albertoboffi-PERSONAL/fra-clock/art/generated/art_dither_0.35mm.png

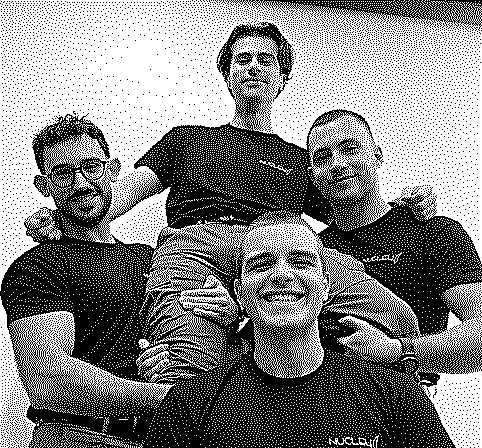
art/generated/art_dither_0.35mm.png
