albertoboffi-PERSONAL/fra-clock/art/generated/foto_neg.png

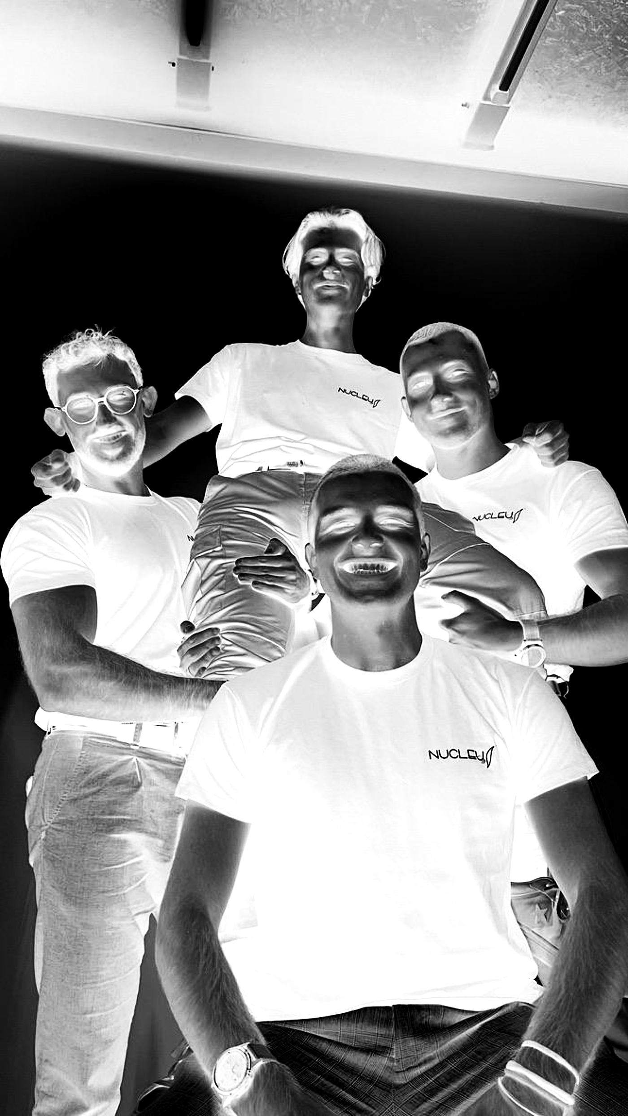
art/generated/foto_neg.png
