albertoboffi-PERSONAL/fra-clock/art/generated/preview_board.png

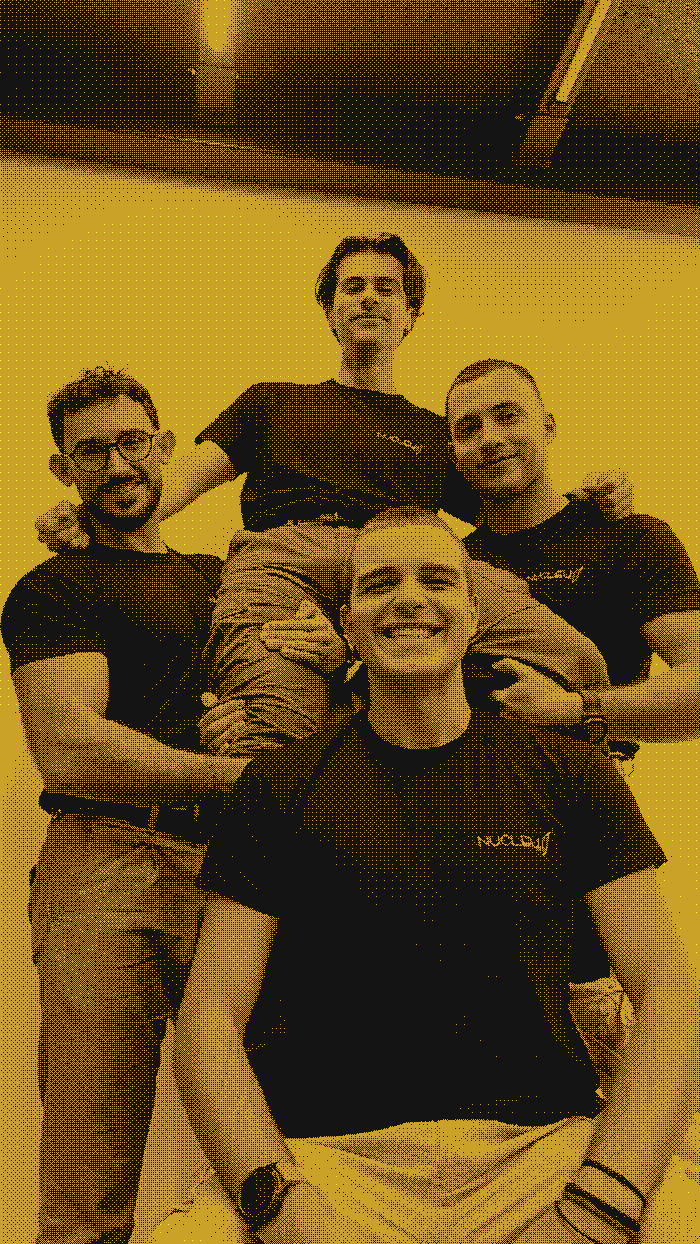
art/generated/preview_board.png
