albertoboffi-PERSONAL/fra-clock/art/source/foto.jpeg

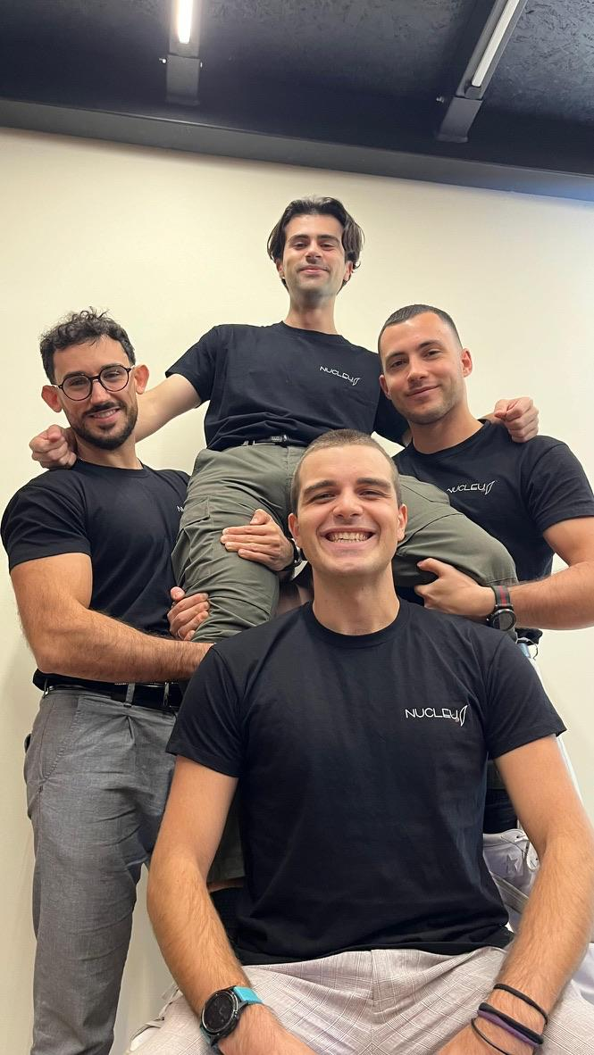
art/source/foto.jpeg
