albertoboffi-PERSONAL/fra-clock/docs/images/render_iso.png

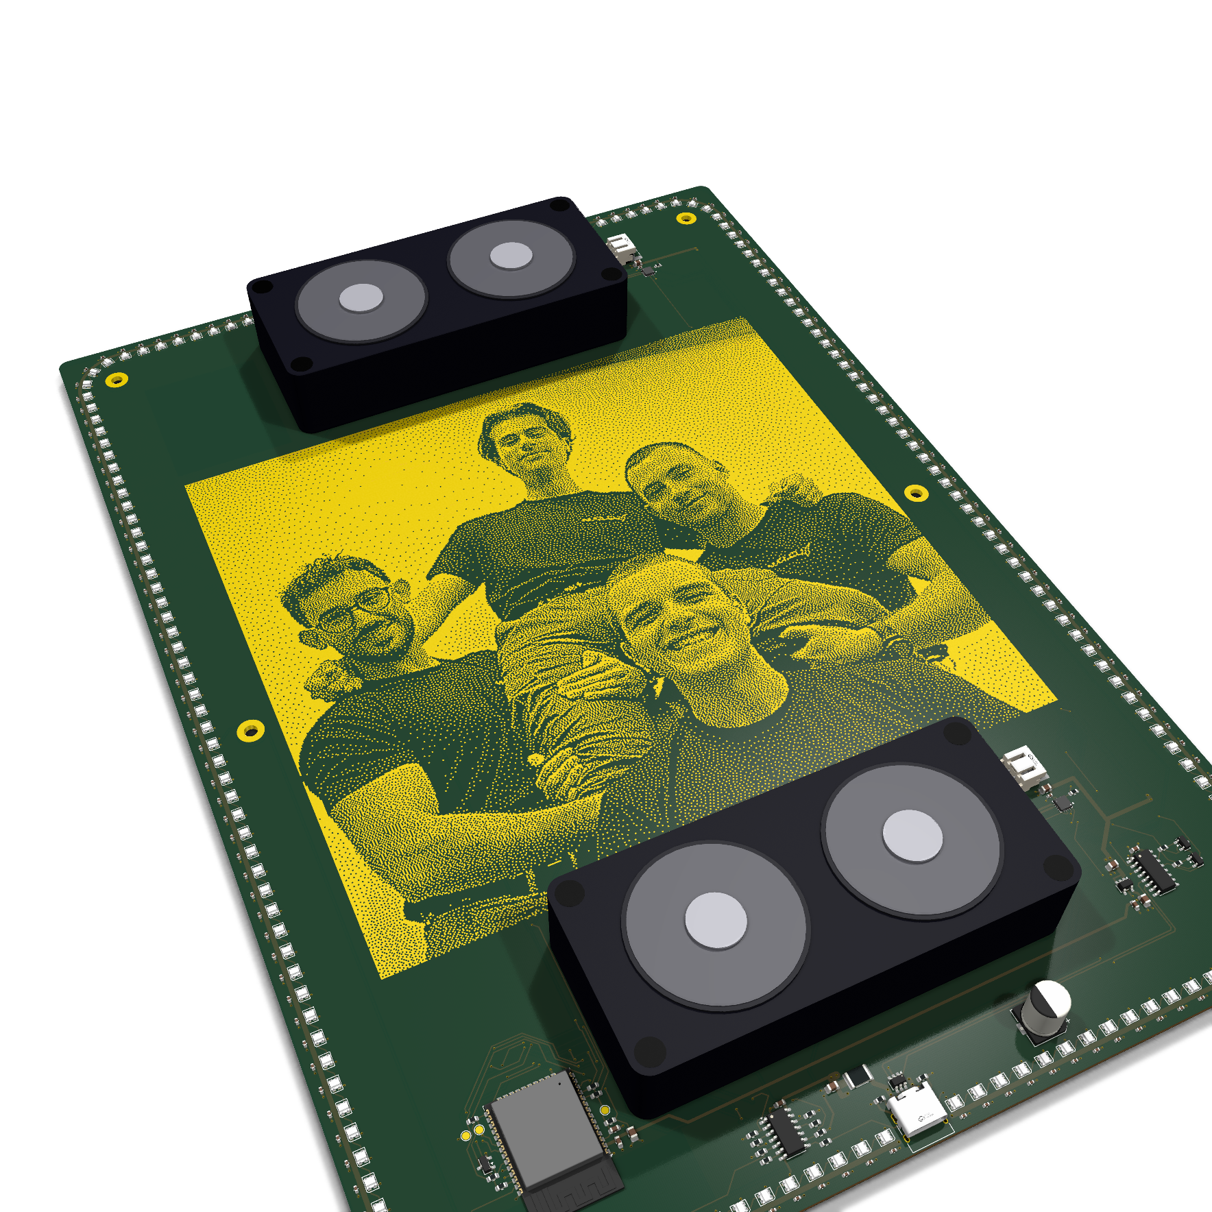
docs/images/render_iso.png
