albertoboffi-PERSONAL/fra-clock/production/preview/gerber_bottom.png

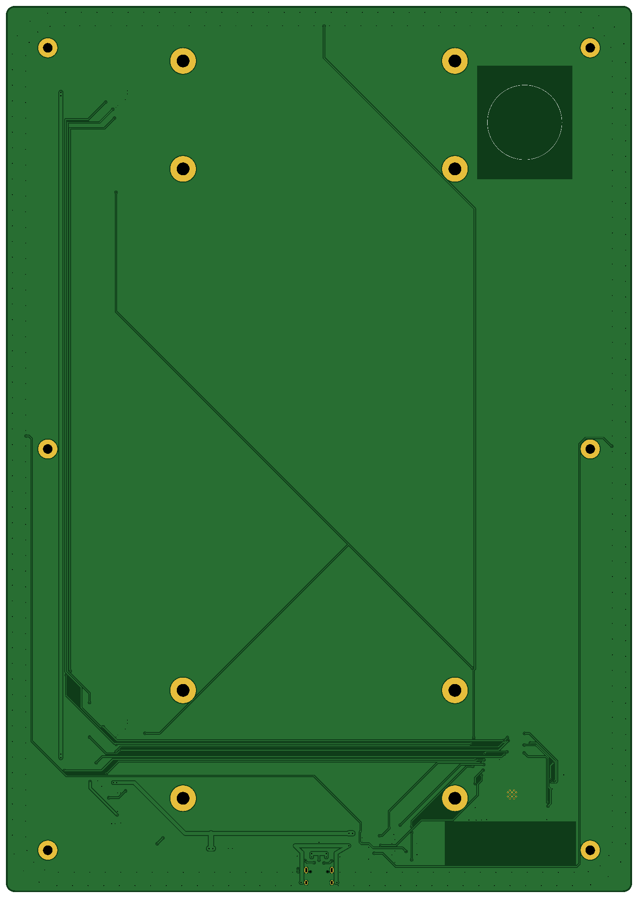
production/preview/gerber_bottom.png
