albertoboffi-PERSONAL/fra-clock/production/preview/gerber_top.png

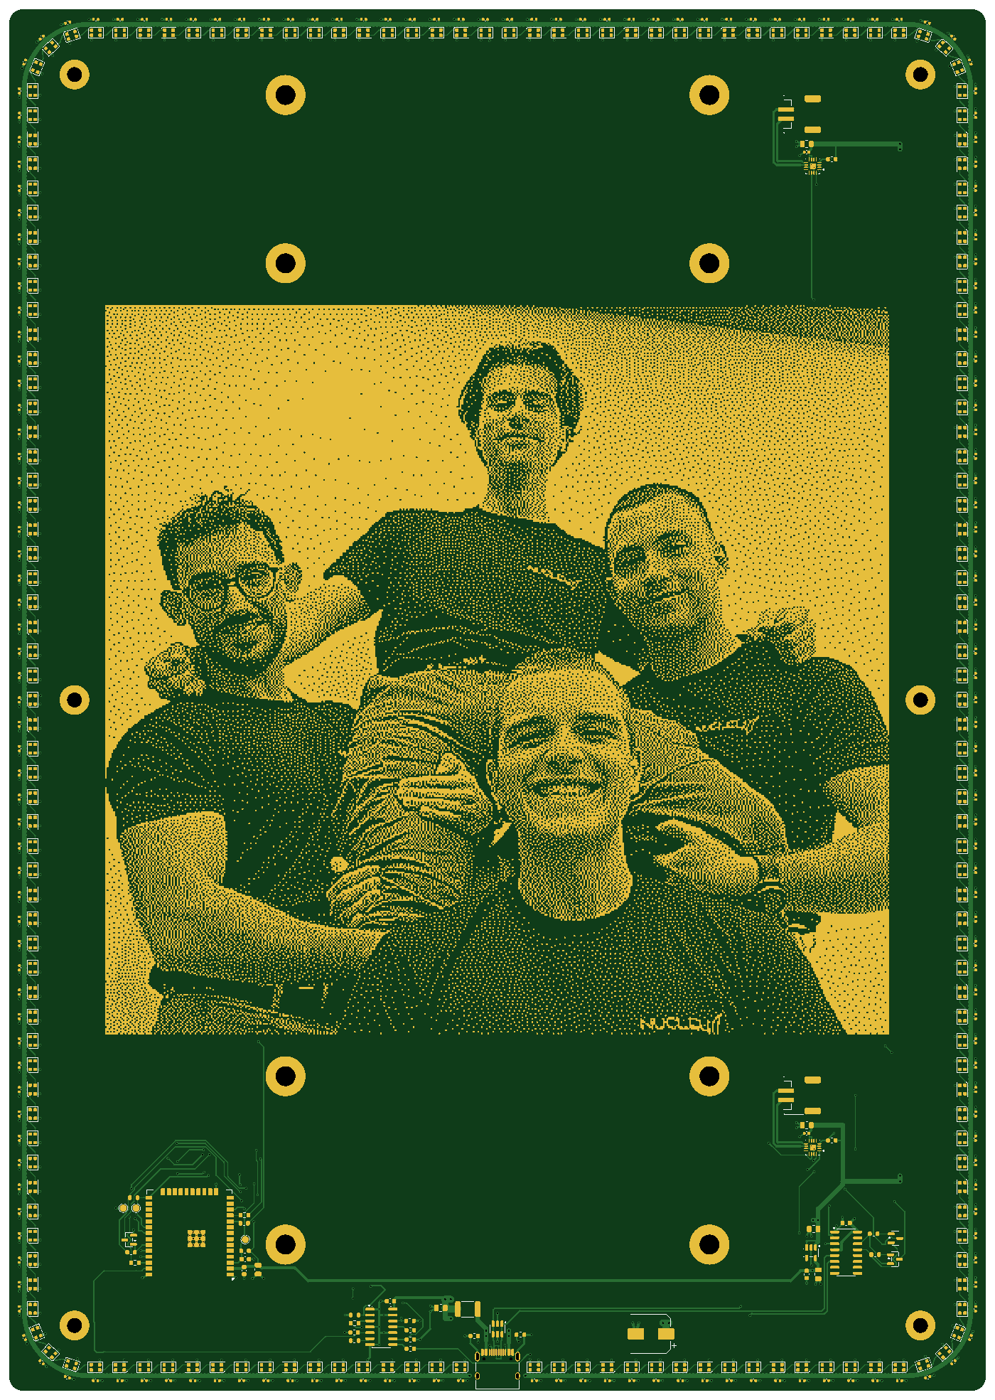
production/preview/gerber_top.png
