albertoboffi-PERSONAL/fra-clock/production/assembly/fra_clock_BOM_JLCPCB.csv

Comment | Designator | Footprint | LCSC Part # | Manufacturer Part | Quantity
100nF | C1,C5,C8,C70 | 0603 | C14663 | CC0603KRX7R9BB104 | 4
22uF | C2 | 0805 | C45783 | CL21A226MAQNNNE | 1
10uF | C3,C4,C6,C71,C72 | 0805 | C15850 | CL21A106KAYNNNE | 5
1uF | C7 | 0603 | C15849 | CL10A105KB8NNNC | 1
470uF | C69 | SMD D8xL10.2 | C82006 | RVT1C471M0810 (16V) | 1
100nF | C101,C102,C201,C202,C203,C204,C205,C206,C207,C208,C209,C210,C211,C212,C213,C214,C215,C216,C217,C218,C219,C220,C221,C222,C223,C224,C225,C226,C227,C228,C229,C230,C231,C232,C233,C234,C235,C236,C237,C238,C239,C240,C241,C242,C243,C244,C245,C301,C302,C303,C304,C305,C306,C307,C308,C309,C310,C311,C312,C313,C314,C315,C316,C317,C318,C319,C320,C321,C322,C323,C324,C325,C326,C327,C328,C329,C330,C331,C332,C333,C334,C335,C336,C337,C338,C339,C340,C341,C342,C343,C344,C345,C401,C402,C403,C404,C405,C406,C407,C408,C409,C410,C411,C412,C413,C414,C415,C416,C417,C418,C419,C420,C421,C422,C423,C424,C425,C426,C427,C428,C429,C430,C431,C432,C433,C434,C435,C436,C437,C438,C439,C440,C441,C442,C443,C444,C445,C501,C502,C503,C504,C505,C506,C507,C508,C509,C510,C511,C512,C513,C514,C515,C516,C517,C518,C519,C520,C521,C522,C523,C524,C525,C526,C527,C528,C529,C530,C531,C532,C533,C534,C535,C536,C537,C538,C539,C540,C541,C542,C543,C544,C545 | 0402 | C1525 | CL05B104KO5NNNC | 182
WS2812B-2020 | D201,D202,D203,D204,D205,D206,D207,D208,D209,D210,D211,D212,D213,D214,D215,D216,D217,D218,D219,D220,D221,D222,D223,D224,D225,D226,D227,D228,D229,D230,D231,D232,D233,D234,D235,D236,D237,D238,D239,D240,D241,D242,D243,D244,D245,D301,D302,D303,D304,D305,D306,D307,D308,D309,D310,D311,D312,D313,D314,D315,D316,D317,D318,D319,D320,D321,D322,D323,D324,D325,D326,D327,D328,D329,D330,D331,D332,D333,D334,D335,D336,D337,D338,D339,D340,D341,D342,D343,D344,D345,D401,D402,D403,D404,D405,D406,D407,D408,D409,D410,D411,D412,D413,D414,D415,D416,D417,D418,D419,D420,D421,D422,D423,D424,D425,D426,D427,D428,D429,D430,D431,D432,D433,D434,D435,D436,D437,D438,D439,D440,D441,D442,D443,D444,D445,D501,D502,D503,D504,D505,D506,D507,D508,D509,D510,D511,D512,D513,D514,D515,D516,D517,D518,D519,D520,D521,D522,D523,D524,D525,D526,D527,D528,D529,D530,D531,D532,D533,D534,D535,D536,D537,D538,D539,D540,D541,D542,D543,D544,D545 | 2020 | C965555 | WS2812B-2020 | 180
2A | F1 | 1812 | C20812 | SMD1812P200TF16 (PTC 2A hold) | 1
USB_C | J1 | USB-C SMD | C165948 | TYPE-C-31-M-12 | 1
S2B-PH-SM4-TB | J101,J102 | JST PH 2P SMD | C295747 | S2B-PH-SM4-TB(LF)(SN) | 2
MMBT3904 | Q1,Q2 | SOT-23 | C20526 | MMBT3904 | 2
2N7002 | Q3 | SOT-23 | C8545 | 2N7002 | 1
5.1k | R1,R2 | 0603 | C23186 | 0603WAF5101T5E | 2
10k | R3,R4,R5,R6,R7,R16,R17,R18 | 0603 | C25804 | 0603WAF1002T5E | 8
470 | R8,R13,R14,R15 | 0603 | C23179 | 0603WAF4700T5E | 4
100k | R9 | 0603 | C25803 | 0603WAF1003T5E | 1
33 | R10,R11,R12 | 0603 | C23140 | 0603WAF330JT5E | 3
1M | R101,R102 | 0603 | C22935 | 0603WAF1004T5E | 2
AP2112K-3.3 | U1 | SOT-23-5 | C51118 | AP2112K-3.3TRG1 | 1
USBLC6-2SC6 | U2 | SOT-23-6 | C7519 | USBLC6-2SC6 | 1
ESP32-WROOM-32E | U3 | Module | C701341 | ESP32-WROOM-32E-N4 | 1
CH340C | U5 | SOIC-16 | C84681 | CH340C | 1
74AHCT125 | U6 | SOIC-14 | C554502 | 74AHCT125D,118 | 1
MAX98357A | U101,U102 | TQFN-16 3x3 | C910544 | MAX98357AETE+T | 2
