albertoboffi-PERSONAL/fra-clock/hardware/fra_clock.kicad_pcb

## KiCad design hardware/fra_clock.kicad_pcb (2026-10-12)

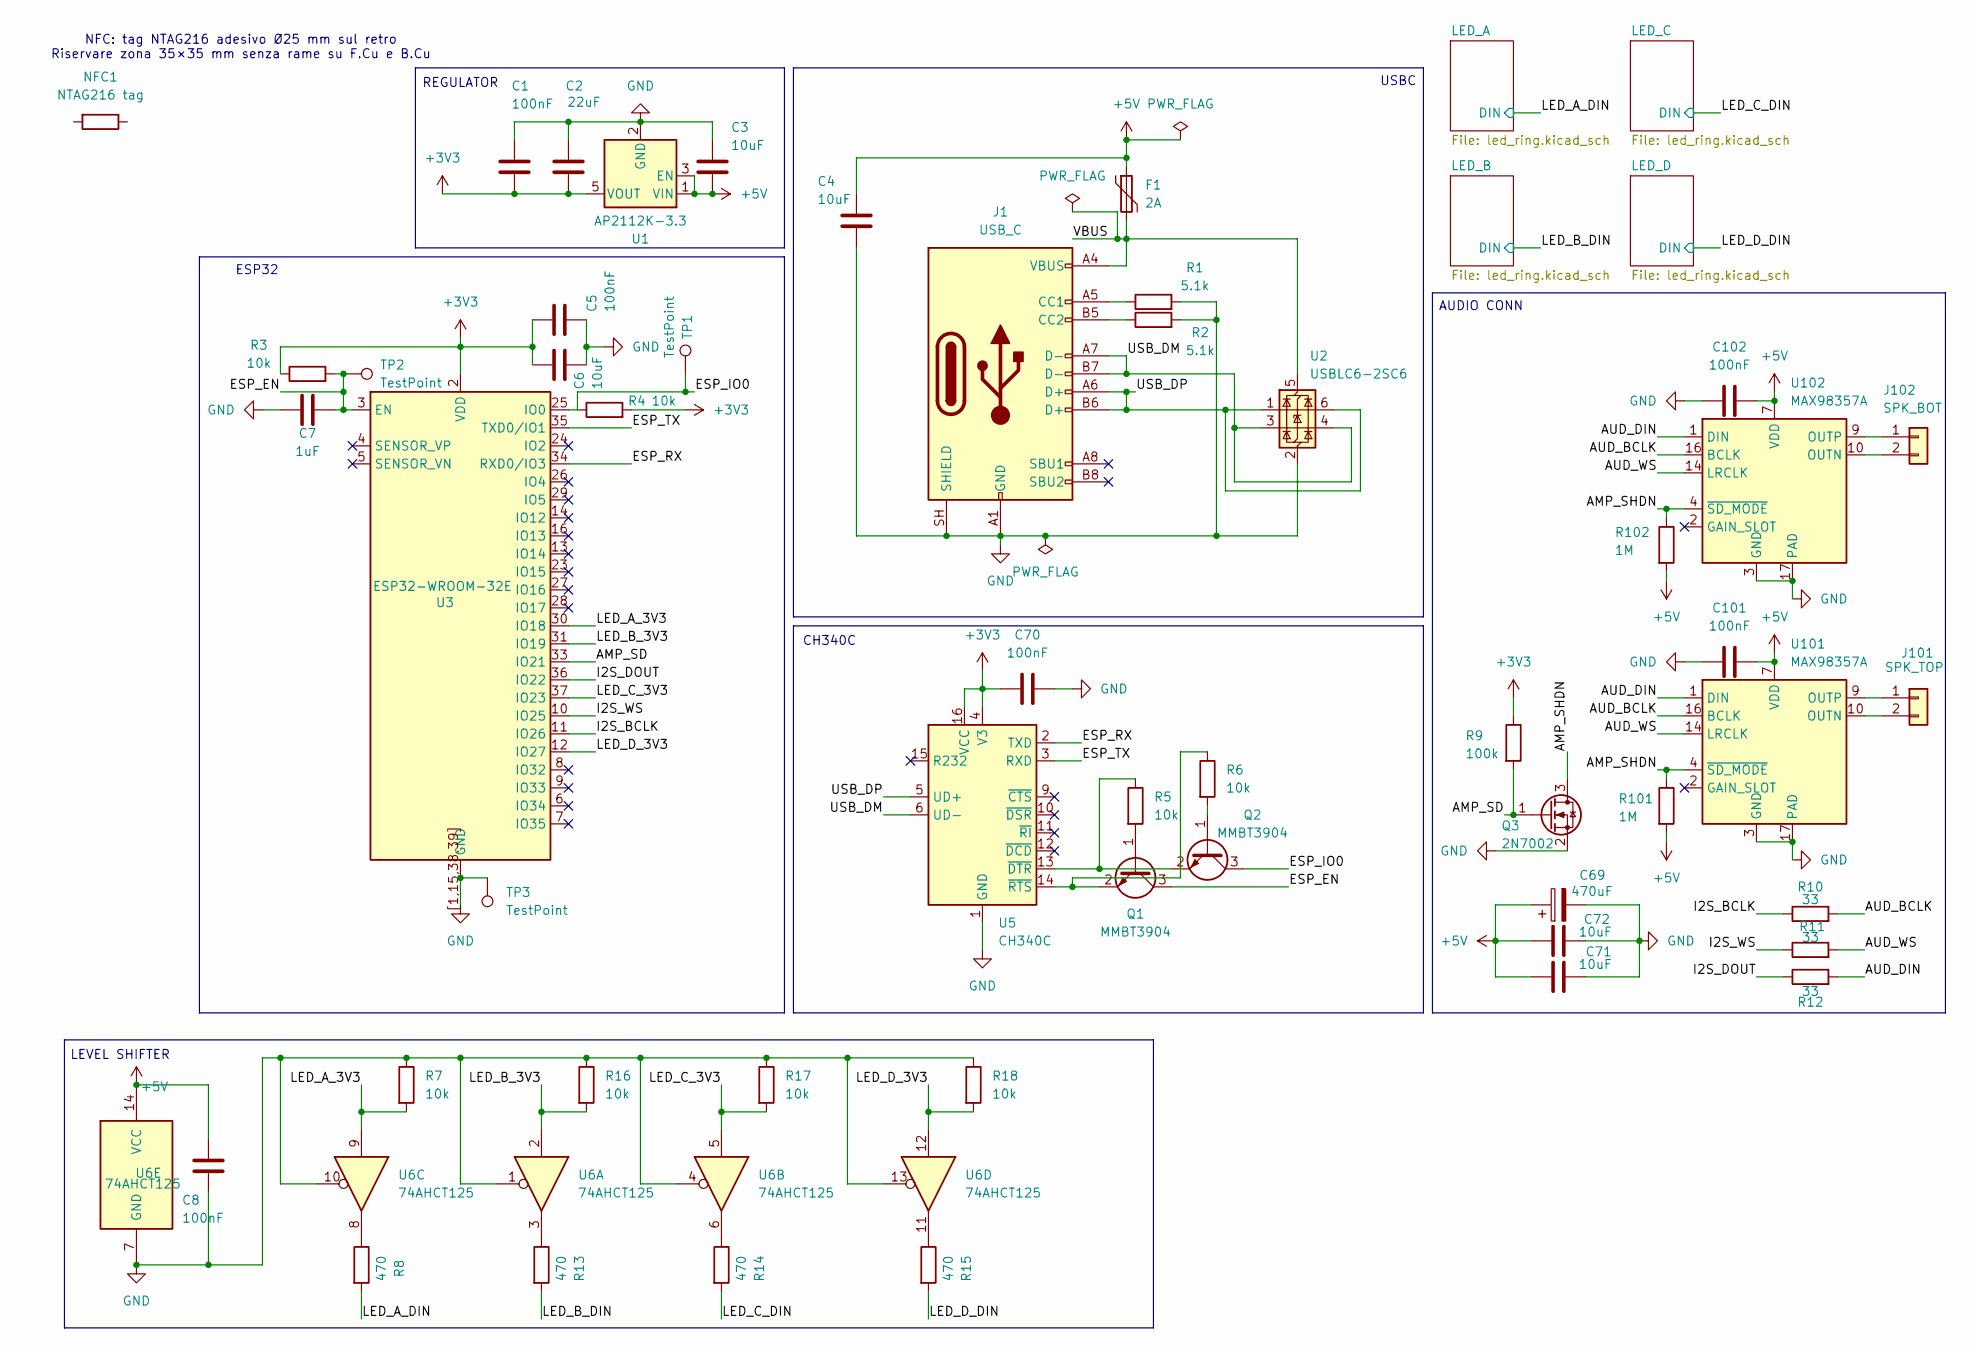
[picture p9: schematic fra_clock.kicad_sch]

Parts:
C1, C5, C8, C70: 100nF; C_0603_1608Metric
C2: 22uF; C_0805_2012Metric
C3, C4, C6, C71, C72: 10uF; C_0805_2012Metric
C7: 1uF; C_0603_1608Metric
C69: 470uF; CP_Elec_8x10
C101, C102: 100nF; C_0402_1005Metric
F1: 2A; Fuse_1812_4532Metric
J1: USB_C; USB_C_Receptacle_HRO_TYPE-C-31-M-12
J101: SPK_TOP; JST_PH_S2B-PH-SM4-TB_1x02-1MP_P2.00mm_Horizontal
J102: SPK_BOT; JST_PH_S2B-PH-SM4-TB_1x02-1MP_P2.00mm_Horizontal
NFC1: NTAG216 tag
Q1, Q2: MMBT3904; SOT-23
Q3: 2N7002; SOT-23
R1, R2: 5.1k; R_0603_1608Metric
R3, R4, R5, R6, R7, R16, R17, R18: 10k; R_0603_1608Metric
R8, R13, R14, R15: 470; R_0603_1608Metric
R9: 100k; R_0603_1608Metric
R10, R11, R12: 33; R_0603_1608Metric
R101, R102: 1M; R_0603_1608Metric
TP1, TP2, TP3: TestPoint; TestPoint_Pad_D1.5mm
U1: AP2112K-3.3; SOT-23-5
U2: USBLC6-2SC6; SOT-23-6
U3: ESP32-WROOM-32E
U5: CH340C; SOIC-16_3.9x9.9mm_P1.27mm
U6: 74AHCT125; SOIC-14_3.9x8.7mm_P1.27mm
U101, U102: MAX98357A; TQFN-16-1EP_3x3mm_P0.5mm_EP1.23x1.23mm

Connections:
+3V3: C1.2, C2.2, C5.1, C6.1, C70.1, R3.1, R4.2, R9.1, U1.5 (VOUT), U3.2 (VDD), U5.4 (V3), U5.16 (VCC)
+5V: C3.2, C4.1, C8.1, C69.1, C71.1, C72.1, C101.1, C102.1, F1.1, R101.2, R102.2, U1.1 (VIN), U1.3 (EN), U6.14 (VCC), U101.7 (VDD), U101.8 (VDD), U102.7 (VDD), U102.8 (VDD); also elsewhere on the board
/AMP_SD: Q3.1 (G), R9.2, U3.33 (IO21)
/AMP_SHDN: Q3.3 (D), R101.1, R102.1, U101.4 (~SD_MODE), U102.4 (~SD_MODE)
/AUD_BCLK: R10.2, U101.16 (BCLK), U102.16 (BCLK)
/AUD_DIN: R12.2, U101.1 (DIN), U102.1 (DIN)
/AUD_WS: R11.2, U101.14 (LRCLK), U102.14 (LRCLK)
/ESP_EN: C7.1, Q1.3 (C), R3.2, TP2.1 (1_1), U3.3 (EN)
/ESP_IO0: Q2.3 (C), R4.1, TP1.1 (1_1), U3.25 (IO0)
/ESP_RX: U3.34 (RXD0/IO3), U5.2 (TXD)
/ESP_TX: U3.35 (TXD0/IO1), U5.3 (RXD)
/I2S_BCLK: R10.1, U3.11 (IO26)
/I2S_DOUT: R12.1, U3.36 (IO22)
/I2S_WS: R11.1, U3.10 (IO25)
/LED_A_3V3: R7.2, U3.30 (IO18), U6.9
/LED_A_DIN: R8.2; also elsewhere on the board
/LED_B_3V3: R16.2, U3.31 (IO19), U6.2
/LED_B_DIN: R13.2; also elsewhere on the board
/LED_C_3V3: R17.2, U3.37 (IO23), U6.5
/LED_C_DIN: R14.2; also elsewhere on the board
/LED_D_3V3: R18.2, U3.12 (IO27), U6.12
/LED_D_DIN: R15.2; also elsewhere on the board
/USB_DM: J1.A7 (D-), J1.B7 (D-), U2.3 (I/O2), U2.4 (I/O2), U5.6 (UD-)
/USB_DP: J1.A6 (D+), J1.B6 (D+), U2.1 (I/O1), U2.6 (I/O1), U5.5 (UD+)
/VBUS: F1.2, J1.A4 (VBUS), J1.A9 (VBUS), J1.B4 (VBUS), J1.B9 (VBUS), U2.5 (VBUS)
GND: C1.1, C2.1, C3.1, C4.2, C5.2, C6.2, C7.2, C8.2, C69.2, C70.2, C71.2, C72.2, C101.2, C102.2, J1.A1 (GND), J1.A12 (GND), J1.B1 (GND), J1.B12 (GND), J1.SH (SHIELD), Q3.2 (S), R1.2, R2.2, R7.1, R16.1, R17.1, R18.1, TP3.1 (1_1), U1.2 (GND), U2.2 (GND), U3.1 (GND), U3.15 (GND), U3.38 (GND), U3.39 (GND), U3.[1,15,38,39] (GND), U5.1 (GND), U6.1, U6.4, U6.7 (GND), U6.10, U6.13, U101.3 (GND), U101.11 (GND), U101.15 (GND), U101.17 (PAD), U102.3 (GND), U102.11 (GND), U102.15 (GND), U102.17 (PAD); also elsewhere on the board
unnamed: J1.A5 (CC1), R1.1
unnamed: J1.B5 (CC2), R2.1
unnamed: J101.1, U101.9 (OUTP)
unnamed: J101.2, U101.10 (OUTN)
unnamed: J102.1, U102.9 (OUTP)
unnamed: J102.2, U102.10 (OUTN)
unnamed: Q1.1 (B), R5.2
unnamed: Q1.2 (E), R6.1, U5.14 (~RTS)
unnamed: Q2.1 (B), R6.2
unnamed: Q2.2 (E), R5.1, U5.13 (~DTR)
unnamed: R8.1, U6.8
unnamed: R13.1, U6.3
unnamed: R14.1, U6.6
unnamed: R15.1, U6.11

Notes on the sheet:
CH340C
USBC
LEVEL SHIFTER
NFC: tag NTAG216 adesivo Ø25 mm sul retro Riservare zona 35×35 mm senza rame su F.Cu e B.Cu
AUDIO CONN
REGULATOR
ESP32

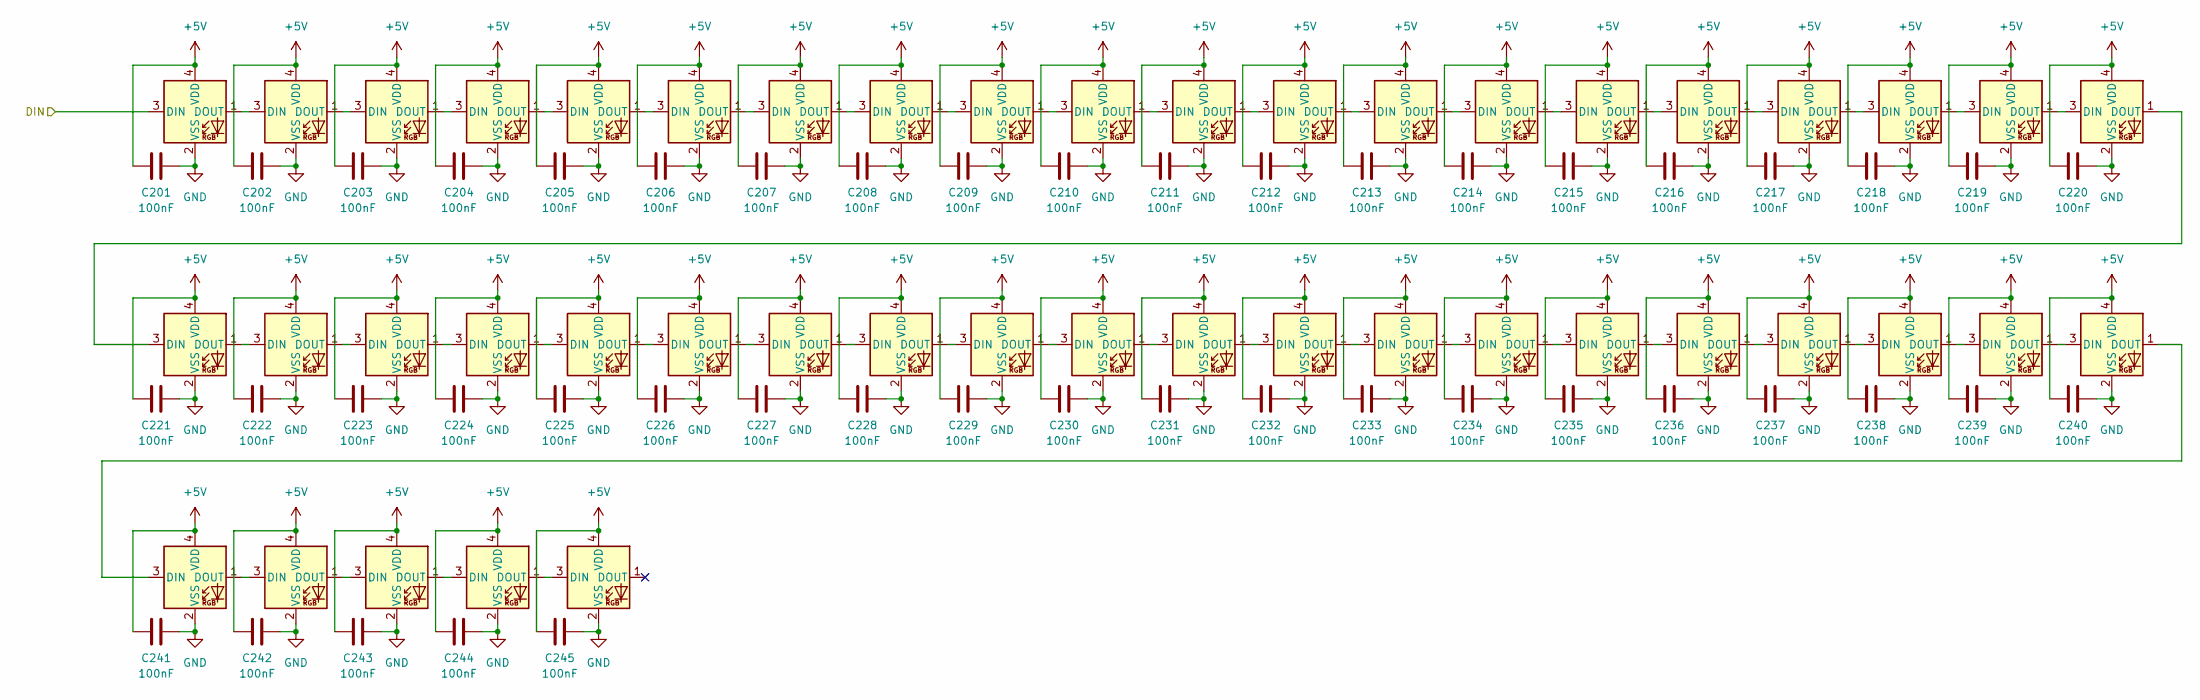
[picture p10: schematic led_ring.kicad_sch]

Parts:
C201, C202, C203, C204, C205, C206, C207, C208, C209, C210, C211, C212, C213, C214, C215, C216, C217, C218, C219, C220, C221, C222, C223, C224, C225, C226, C227, C228, C229, C230, C231, C232, C233, C234, C235, C236, C237, C238, C239, C240, C241, C242, C243, C244, C245: 100nF; C_0402_1005Metric
D201, D202, D203, D204, D205, D206, D207, D208, D209, D210, D211, D212, D213, D214, D215, D216, D217, D218, D219, D220, D221, D222, D223, D224, D225, D226, D227, D228, D229, D230, D231, D232, D233, D234, D235, D236, D237, D238, D239, D240, D241, D242, D243, D244, D245: WS2812B-2020; LED_WS2812B-2020_PLCC4_2.0x2.0mm

Connections:
+5V: C201.2, C202.2, C203.2, C204.2, C205.2, C206.2, C207.2, C208.2, C209.2, C210.2, C211.2, C212.2, C213.2, C214.2, C215.2, C216.2, C217.2, C218.2, C219.2, C220.2, C221.2, C222.2, C223.2, C224.2, C225.2, C226.2, C227.2, C228.2, C229.2, C230.2, C231.2, C232.2, C233.2, C234.2, C235.2, C236.2, C237.2, C238.2, C239.2, C240.2, C241.2, C242.2, C243.2, C244.2, C245.2, D201.4 (VDD), D202.4 (VDD), D203.4 (VDD), D204.4 (VDD), D205.4 (VDD), D206.4 (VDD), D207.4 (VDD), D208.4 (VDD), D209.4 (VDD), D210.4 (VDD), D211.4 (VDD), D212.4 (VDD), D213.4 (VDD), D214.4 (VDD), D215.4 (VDD), D216.4 (VDD), D217.4 (VDD), D218.4 (VDD), D219.4 (VDD), D220.4 (VDD), D221.4 (VDD), D222.4 (VDD), D223.4 (VDD), D224.4 (VDD), D225.4 (VDD), D226.4 (VDD), D227.4 (VDD), D228.4 (VDD), D229.4 (VDD), D230.4 (VDD), D231.4 (VDD), D232.4 (VDD), D233.4 (VDD), D234.4 (VDD), D235.4 (VDD), D236.4 (VDD), D237.4 (VDD), D238.4 (VDD), D239.4 (VDD), D240.4 (VDD), D241.4 (VDD), D242.4 (VDD), D243.4 (VDD), D244.4 (VDD), D245.4 (VDD); also elsewhere on the board
/LED_A_DIN: D201.3 (DIN); also elsewhere on the board
GND: C201.1, C202.1, C203.1, C204.1, C205.1, C206.1, C207.1, C208.1, C209.1, C210.1, C211.1, C212.1, C213.1, C214.1, C215.1, C216.1, C217.1, C218.1, C219.1, C220.1, C221.1, C222.1, C223.1, C224.1, C225.1, C226.1, C227.1, C228.1, C229.1, C230.1, C231.1, C232.1, C233.1, C234.1, C235.1, C236.1, C237.1, C238.1, C239.1, C240.1, C241.1, C242.1, C243.1, C244.1, C245.1, D201.2 (VSS), D202.2 (VSS), D203.2 (VSS), D204.2 (VSS), D205.2 (VSS), D206.2 (VSS), D207.2 (VSS), D208.2 (VSS), D209.2 (VSS), D210.2 (VSS), D211.2 (VSS), D212.2 (VSS), D213.2 (VSS), D214.2 (VSS), D215.2 (VSS), D216.2 (VSS), D217.2 (VSS), D218.2 (VSS), D219.2 (VSS), D220.2 (VSS), D221.2 (VSS), D222.2 (VSS), D223.2 (VSS), D224.2 (VSS), D225.2 (VSS), D226.2 (VSS), D227.2 (VSS), D228.2 (VSS), D229.2 (VSS), D230.2 (VSS), D231.2 (VSS), D232.2 (VSS), D233.2 (VSS), D234.2 (VSS), D235.2 (VSS), D236.2 (VSS), D237.2 (VSS), D238.2 (VSS), D239.2 (VSS), D240.2 (VSS), D241.2 (VSS), D242.2 (VSS), D243.2 (VSS), D244.2 (VSS), D245.2 (VSS); also elsewhere on the board
unnamed: D201.1 (DOUT), D202.3 (DIN)
unnamed: D202.1 (DOUT), D203.3 (DIN)
unnamed: D203.1 (DOUT), D204.3 (DIN)
unnamed: D204.1 (DOUT), D205.3 (DIN)
unnamed: D205.1 (DOUT), D206.3 (DIN)
unnamed: D206.1 (DOUT), D207.3 (DIN)
unnamed: D207.1 (DOUT), D208.3 (DIN)
unnamed: D208.1 (DOUT), D209.3 (DIN)
unnamed: D209.1 (DOUT), D210.3 (DIN)
unnamed: D210.1 (DOUT), D211.3 (DIN)
unnamed: D211.1 (DOUT), D212.3 (DIN)
unnamed: D212.1 (DOUT), D213.3 (DIN)
unnamed: D213.1 (DOUT), D214.3 (DIN)
unnamed: D214.1 (DOUT), D215.3 (DIN)
unnamed: D215.1 (DOUT), D216.3 (DIN)
unnamed: D216.1 (DOUT), D217.3 (DIN)
unnamed: D217.1 (DOUT), D218.3 (DIN)
unnamed: D218.1 (DOUT), D219.3 (DIN)
unnamed: D219.1 (DOUT), D220.3 (DIN)
unnamed: D220.1 (DOUT), D221.3 (DIN)
unnamed: D221.1 (DOUT), D222.3 (DIN)
unnamed: D222.1 (DOUT), D223.3 (DIN)
unnamed: D223.1 (DOUT), D224.3 (DIN)
unnamed: D224.1 (DOUT), D225.3 (DIN)
unnamed: D225.1 (DOUT), D226.3 (DIN)
unnamed: D226.1 (DOUT), D227.3 (DIN)
unnamed: D227.1 (DOUT), D228.3 (DIN)
unnamed: D228.1 (DOUT), D229.3 (DIN)
unnamed: D229.1 (DOUT), D230.3 (DIN)
unnamed: D230.1 (DOUT), D231.3 (DIN)
unnamed: D231.1 (DOUT), D232.3 (DIN)
unnamed: D232.1 (DOUT), D233.3 (DIN)
unnamed: D233.1 (DOUT), D234.3 (DIN)
unnamed: D234.1 (DOUT), D235.3 (DIN)
unnamed: D235.1 (DOUT), D236.3 (DIN)
unnamed: D236.1 (DOUT), D237.3 (DIN)
unnamed: D237.1 (DOUT), D238.3 (DIN)
unnamed: D238.1 (DOUT), D239.3 (DIN)
unnamed: D239.1 (DOUT), D240.3 (DIN)
unnamed: D240.1 (DOUT), D241.3 (DIN)
unnamed: D241.1 (DOUT), D242.3 (DIN)
unnamed: D242.1 (DOUT), D243.3 (DIN)
unnamed: D243.1 (DOUT), D244.3 (DIN)
unnamed: D244.1 (DOUT), D245.3 (DIN)

Parts of its further copies:
C301, C302, C303, C304, C305, C306, C307, C308, C309, C310, C311, C312, C313, C314, C315, C316, C317, C318, C319, C320, C321, C322, C323, C324, C325, C326, C327, C328, C329, C330, C331, C332, C333, C334, C335, C336, C337, C338, C339, C340, C341, C342, C343, C344, C345, C401, C402, C403, C404, C405, C406, C407, C408, C409, C410, C411, C412, C413, C414, C415, C416, C417, C418, C419, C420, C421, C422, C423, C424, C425, C426, C427, C428, C429, C430, C431, C432, C433, C434, C435, C436, C437, C438, C439, C440, C441, C442, C443, C444, C445, C501, C502, C503, C504, C505, C506, C507, C508, C509, C510, C511, C512, C513, C514, C515, C516, C517, C518, C519, C520, C521, C522, C523, C524, C525, C526, C527, C528, C529, C530, C531, C532, C533, C534, C535, C536, C537, C538, C539, C540, C541, C542, C543, C544, C545: 100nF; C_0402_1005Metric
D301, D302, D303, D304, D305, D306, D307, D308, D309, D310, D311, D312, D313, D314, D315, D316, D317, D318, D319, D320, D321, D322, D323, D324, D325, D326, D327, D328, D329, D330, D331, D332, D333, D334, D335, D336, D337, D338, D339, D340, D341, D342, D343, D344, D345, D401, D402, D403, D404, D405, D406, D407, D408, D409, D410, D411, D412, D413, D414, D415, D416, D417, D418, D419, D420, D421, D422, D423, D424, D425, D426, D427, D428, D429, D430, D431, D432, D433, D434, D435, D436, D437, D438, D439, D440, D441, D442, D443, D444, D445, D501, D502, D503, D504, D505, D506, D507, D508, D509, D510, D511, D512, D513, D514, D515, D516, D517, D518, D519, D520, D521, D522, D523, D524, D525, D526, D527, D528, D529, D530, D531, D532, D533, D534, D535, D536, D537, D538, D539, D540, D541, D542, D543, D544, D545: WS2812B-2020; LED_WS2812B-2020_PLCC4_2.0x2.0mm

Connections of its further copies:
+5V: C301.2, C302.2, C303.2, C304.2, C305.2, C306.2, C307.2, C308.2, C309.2, C310.2, C311.2, C312.2, C313.2, C314.2, C315.2, C316.2, C317.2, C318.2, C319.2, C320.2, C321.2, C322.2, C323.2, C324.2, C325.2, C326.2, C327.2, C328.2, C329.2, C330.2, C331.2, C332.2, C333.2, C334.2, C335.2, C336.2, C337.2, C338.2, C339.2, C340.2, C341.2, C342.2, C343.2, C344.2, C345.2, C401.2, C402.2, C403.2, C404.2, C405.2, C406.2, C407.2, C408.2, C409.2, C410.2, C411.2, C412.2, C413.2, C414.2, C415.2, C416.2, C417.2, C418.2, C419.2, C420.2, C421.2, C422.2, C423.2, C424.2, C425.2, C426.2, C427.2, C428.2, C429.2, C430.2, C431.2, C432.2, C433.2, C434.2, C435.2, C436.2, C437.2, C438.2, C439.2, C440.2, C441.2, C442.2, C443.2, C444.2, C445.2, C501.2, C502.2, C503.2, C504.2, C505.2, C506.2, C507.2, C508.2, C509.2, C510.2, C511.2, C512.2, C513.2, C514.2, C515.2, C516.2, C517.2, C518.2, C519.2, C520.2, C521.2, C522.2, C523.2, C524.2, C525.2, C526.2, C527.2, C528.2, C529.2, C530.2, C531.2, C532.2, C533.2, C534.2, C535.2, C536.2, C537.2, C538.2, C539.2, C540.2, C541.2, C542.2, C543.2, C544.2, C545.2, D301.4 (VDD), D302.4 (VDD), D303.4 (VDD), D304.4 (VDD), D305.4 (VDD), D306.4 (VDD), D307.4 (VDD), D308.4 (VDD), D309.4 (VDD), D310.4 (VDD), D311.4 (VDD), D312.4 (VDD), D313.4 (VDD), D314.4 (VDD), D315.4 (VDD), D316.4 (VDD), D317.4 (VDD), D318.4 (VDD), D319.4 (VDD), D320.4 (VDD), D321.4 (VDD), D322.4 (VDD), D323.4 (VDD), D324.4 (VDD), D325.4 (VDD), D326.4 (VDD), D327.4 (VDD), D328.4 (VDD), D329.4 (VDD), D330.4 (VDD), D331.4 (VDD), D332.4 (VDD), D333.4 (VDD), D334.4 (VDD), D335.4 (VDD), D336.4 (VDD), D337.4 (VDD), D338.4 (VDD), D339.4 (VDD), D340.4 (VDD), D341.4 (VDD), D342.4 (VDD), D343.4 (VDD), D344.4 (VDD), D345.4 (VDD), D401.4 (VDD), D402.4 (VDD), D403.4 (VDD), D404.4 (VDD), D405.4 (VDD), D406.4 (VDD), D407.4 (VDD), D408.4 (VDD), D409.4 (VDD), D410.4 (VDD), D411.4 (VDD), D412.4 (VDD), D413.4 (VDD), D414.4 (VDD), D415.4 (VDD), D416.4 (VDD), D417.4 (VDD), D418.4 (VDD), D419.4 (VDD), D420.4 (VDD), D421.4 (VDD), D422.4 (VDD), D423.4 (VDD), D424.4 (VDD), D425.4 (VDD), D426.4 (VDD), D427.4 (VDD), D428.4 (VDD), D429.4 (VDD), D430.4 (VDD), D431.4 (VDD), D432.4 (VDD), D433.4 (VDD), D434.4 (VDD), D435.4 (VDD), D436.4 (VDD), D437.4 (VDD), D438.4 (VDD), D439.4 (VDD), D440.4 (VDD), D441.4 (VDD), D442.4 (VDD), D443.4 (VDD), D444.4 (VDD), D445.4 (VDD), D501.4 (VDD), D502.4 (VDD), D503.4 (VDD), D504.4 (VDD), D505.4 (VDD), D506.4 (VDD), D507.4 (VDD), D508.4 (VDD), D509.4 (VDD), D510.4 (VDD), D511.4 (VDD), D512.4 (VDD), D513.4 (VDD), D514.4 (VDD), D515.4 (VDD), D516.4 (VDD), D517.4 (VDD), D518.4 (VDD), D519.4 (VDD), D520.4 (VDD), D521.4 (VDD), D522.4 (VDD), D523.4 (VDD), D524.4 (VDD), D525.4 (VDD), D526.4 (VDD), D527.4 (VDD), D528.4 (VDD), D529.4 (VDD), D530.4 (VDD), D531.4 (VDD), D532.4 (VDD), D533.4 (VDD), D534.4 (VDD), D535.4 (VDD), D536.4 (VDD), D537.4 (VDD), D538.4 (VDD), D539.4 (VDD), D540.4 (VDD), D541.4 (VDD), D542.4 (VDD), D543.4 (VDD), D544.4 (VDD), D545.4 (VDD); also elsewhere on the board
/LED_B_DIN: D301.3 (DIN); also elsewhere on the board
/LED_C_DIN: D401.3 (DIN); also elsewhere on the board
/LED_D_DIN: D501.3 (DIN); also elsewhere on the board
GND: C301.1, C302.1, C303.1, C304.1, C305.1, C306.1, C307.1, C308.1, C309.1, C310.1, C311.1, C312.1, C313.1, C314.1, C315.1, C316.1, C317.1, C318.1, C319.1, C320.1, C321.1, C322.1, C323.1, C324.1, C325.1, C326.1, C327.1, C328.1, C329.1, C330.1, C331.1, C332.1, C333.1, C334.1, C335.1, C336.1, C337.1, C338.1, C339.1, C340.1, C341.1, C342.1, C343.1, C344.1, C345.1, C401.1, C402.1, C403.1, C404.1, C405.1, C406.1, C407.1, C408.1, C409.1, C410.1, C411.1, C412.1, C413.1, C414.1, C415.1, C416.1, C417.1, C418.1, C419.1, C420.1, C421.1, C422.1, C423.1, C424.1, C425.1, C426.1, C427.1, C428.1, C429.1, C430.1, C431.1, C432.1, C433.1, C434.1, C435.1, C436.1, C437.1, C438.1, C439.1, C440.1, C441.1, C442.1, C443.1, C444.1, C445.1, C501.1, C502.1, C503.1, C504.1, C505.1, C506.1, C507.1, C508.1, C509.1, C510.1, C511.1, C512.1, C513.1, C514.1, C515.1, C516.1, C517.1, C518.1, C519.1, C520.1, C521.1, C522.1, C523.1, C524.1, C525.1, C526.1, C527.1, C528.1, C529.1, C530.1, C531.1, C532.1, C533.1, C534.1, C535.1, C536.1, C537.1, C538.1, C539.1, C540.1, C541.1, C542.1, C543.1, C544.1, C545.1, D301.2 (VSS), D302.2 (VSS), D303.2 (VSS), D304.2 (VSS), D305.2 (VSS), D306.2 (VSS), D307.2 (VSS), D308.2 (VSS), D309.2 (VSS), D310.2 (VSS), D311.2 (VSS), D312.2 (VSS), D313.2 (VSS), D314.2 (VSS), D315.2 (VSS), D316.2 (VSS), D317.2 (VSS), D318.2 (VSS), D319.2 (VSS), D320.2 (VSS), D321.2 (VSS), D322.2 (VSS), D323.2 (VSS), D324.2 (VSS), D325.2 (VSS), D326.2 (VSS), D327.2 (VSS), D328.2 (VSS), D329.2 (VSS), D330.2 (VSS), D331.2 (VSS), D332.2 (VSS), D333.2 (VSS), D334.2 (VSS), D335.2 (VSS), D336.2 (VSS), D337.2 (VSS), D338.2 (VSS), D339.2 (VSS), D340.2 (VSS), D341.2 (VSS), D342.2 (VSS), D343.2 (VSS), D344.2 (VSS), D345.2 (VSS), D401.2 (VSS), D402.2 (VSS), D403.2 (VSS), D404.2 (VSS), D405.2 (VSS), D406.2 (VSS), D407.2 (VSS), D408.2 (VSS), D409.2 (VSS), D410.2 (VSS), D411.2 (VSS), D412.2 (VSS), D413.2 (VSS), D414.2 (VSS), D415.2 (VSS), D416.2 (VSS), D417.2 (VSS), D418.2 (VSS), D419.2 (VSS), D420.2 (VSS), D421.2 (VSS), D422.2 (VSS), D423.2 (VSS), D424.2 (VSS), D425.2 (VSS), D426.2 (VSS), D427.2 (VSS), D428.2 (VSS), D429.2 (VSS), D430.2 (VSS), D431.2 (VSS), D432.2 (VSS), D433.2 (VSS), D434.2 (VSS), D435.2 (VSS), D436.2 (VSS), D437.2 (VSS), D438.2 (VSS), D439.2 (VSS), D440.2 (VSS), D441.2 (VSS), D442.2 (VSS), D443.2 (VSS), D444.2 (VSS), D445.2 (VSS), D501.2 (VSS), D502.2 (VSS), D503.2 (VSS), D504.2 (VSS), D505.2 (VSS), D506.2 (VSS), D507.2 (VSS), D508.2 (VSS), D509.2 (VSS), D510.2 (VSS), D511.2 (VSS), D512.2 (VSS), D513.2 (VSS), D514.2 (VSS), D515.2 (VSS), D516.2 (VSS), D517.2 (VSS), D518.2 (VSS), D519.2 (VSS), D520.2 (VSS), D521.2 (VSS), D522.2 (VSS), D523.2 (VSS), D524.2 (VSS), D525.2 (VSS), D526.2 (VSS), D527.2 (VSS), D528.2 (VSS), D529.2 (VSS), D530.2 (VSS), D531.2 (VSS), D532.2 (VSS), D533.2 (VSS), D534.2 (VSS), D535.2 (VSS), D536.2 (VSS), D537.2 (VSS), D538.2 (VSS), D539.2 (VSS), D540.2 (VSS), D541.2 (VSS), D542.2 (VSS), D543.2 (VSS), D544.2 (VSS), D545.2 (VSS); also elsewhere on the board
unnamed: D301.1 (DOUT), D302.3 (DIN)
unnamed: D302.1 (DOUT), D303.3 (DIN)
unnamed: D303.1 (DOUT), D304.3 (DIN)
unnamed: D304.1 (DOUT), D305.3 (DIN)
unnamed: D305.1 (DOUT), D306.3 (DIN)
unnamed: D306.1 (DOUT), D307.3 (DIN)
unnamed: D307.1 (DOUT), D308.3 (DIN)
unnamed: D308.1 (DOUT), D309.3 (DIN)
unnamed: D309.1 (DOUT), D310.3 (DIN)
unnamed: D310.1 (DOUT), D311.3 (DIN)
unnamed: D311.1 (DOUT), D312.3 (DIN)
unnamed: D312.1 (DOUT), D313.3 (DIN)
unnamed: D313.1 (DOUT), D314.3 (DIN)
unnamed: D314.1 (DOUT), D315.3 (DIN)
unnamed: D315.1 (DOUT), D316.3 (DIN)
unnamed: D316.1 (DOUT), D317.3 (DIN)
unnamed: D317.1 (DOUT), D318.3 (DIN)
unnamed: D318.1 (DOUT), D319.3 (DIN)
unnamed: D319.1 (DOUT), D320.3 (DIN)
unnamed: D320.1 (DOUT), D321.3 (DIN)
unnamed: D321.1 (DOUT), D322.3 (DIN)
unnamed: D322.1 (DOUT), D323.3 (DIN)
unnamed: D323.1 (DOUT), D324.3 (DIN)
unnamed: D324.1 (DOUT), D325.3 (DIN)
unnamed: D325.1 (DOUT), D326.3 (DIN)
unnamed: D326.1 (DOUT), D327.3 (DIN)
unnamed: D327.1 (DOUT), D328.3 (DIN)
unnamed: D328.1 (DOUT), D329.3 (DIN)
unnamed: D329.1 (DOUT), D330.3 (DIN)
unnamed: D330.1 (DOUT), D331.3 (DIN)
unnamed: D331.1 (DOUT), D332.3 (DIN)
unnamed: D332.1 (DOUT), D333.3 (DIN)
unnamed: D333.1 (DOUT), D334.3 (DIN)
unnamed: D334.1 (DOUT), D335.3 (DIN)
unnamed: D335.1 (DOUT), D336.3 (DIN)
unnamed: D336.1 (DOUT), D337.3 (DIN)
unnamed: D337.1 (DOUT), D338.3 (DIN)
unnamed: D338.1 (DOUT), D339.3 (DIN)
unnamed: D339.1 (DOUT), D340.3 (DIN)
unnamed: D340.1 (DOUT), D341.3 (DIN)
unnamed: D341.1 (DOUT), D342.3 (DIN)
unnamed: D342.1 (DOUT), D343.3 (DIN)
unnamed: D343.1 (DOUT), D344.3 (DIN)
unnamed: D344.1 (DOUT), D345.3 (DIN)
unnamed: D401.1 (DOUT), D402.3 (DIN)
unnamed: D402.1 (DOUT), D403.3 (DIN)
unnamed: D403.1 (DOUT), D404.3 (DIN)
unnamed: D404.1 (DOUT), D405.3 (DIN)
unnamed: D405.1 (DOUT), D406.3 (DIN)
unnamed: D406.1 (DOUT), D407.3 (DIN)
unnamed: D407.1 (DOUT), D408.3 (DIN)
unnamed: D408.1 (DOUT), D409.3 (DIN)
unnamed: D409.1 (DOUT), D410.3 (DIN)
unnamed: D410.1 (DOUT), D411.3 (DIN)
unnamed: D411.1 (DOUT), D412.3 (DIN)
unnamed: D412.1 (DOUT), D413.3 (DIN)
unnamed: D413.1 (DOUT), D414.3 (DIN)
unnamed: D414.1 (DOUT), D415.3 (DIN)
unnamed: D415.1 (DOUT), D416.3 (DIN)
unnamed: D416.1 (DOUT), D417.3 (DIN)
unnamed: D417.1 (DOUT), D418.3 (DIN)
unnamed: D418.1 (DOUT), D419.3 (DIN)
unnamed: D419.1 (DOUT), D420.3 (DIN)
unnamed: D420.1 (DOUT), D421.3 (DIN)
unnamed: D421.1 (DOUT), D422.3 (DIN)
unnamed: D422.1 (DOUT), D423.3 (DIN)
unnamed: D423.1 (DOUT), D424.3 (DIN)
unnamed: D424.1 (DOUT), D425.3 (DIN)
unnamed: D425.1 (DOUT), D426.3 (DIN)
unnamed: D426.1 (DOUT), D427.3 (DIN)
unnamed: D427.1 (DOUT), D428.3 (DIN)
unnamed: D428.1 (DOUT), D429.3 (DIN)
unnamed: D429.1 (DOUT), D430.3 (DIN)
unnamed: D430.1 (DOUT), D431.3 (DIN)
unnamed: D431.1 (DOUT), D432.3 (DIN)
unnamed: D432.1 (DOUT), D433.3 (DIN)
unnamed: D433.1 (DOUT), D434.3 (DIN)
unnamed: D434.1 (DOUT), D435.3 (DIN)
unnamed: D435.1 (DOUT), D436.3 (DIN)
unnamed: D436.1 (DOUT), D437.3 (DIN)
unnamed: D437.1 (DOUT), D438.3 (DIN)
unnamed: D438.1 (DOUT), D439.3 (DIN)
unnamed: D439.1 (DOUT), D440.3 (DIN)
unnamed: D440.1 (DOUT), D441.3 (DIN)
unnamed: D441.1 (DOUT), D442.3 (DIN)
unnamed: D442.1 (DOUT), D443.3 (DIN)
unnamed: D443.1 (DOUT), D444.3 (DIN)
unnamed: D444.1 (DOUT), D445.3 (DIN)
unnamed: D501.1 (DOUT), D502.3 (DIN)
unnamed: D502.1 (DOUT), D503.3 (DIN)
unnamed: D503.1 (DOUT), D504.3 (DIN)
unnamed: D504.1 (DOUT), D505.3 (DIN)
unnamed: D505.1 (DOUT), D506.3 (DIN)
unnamed: D506.1 (DOUT), D507.3 (DIN)
unnamed: D507.1 (DOUT), D508.3 (DIN)
unnamed: D508.1 (DOUT), D509.3 (DIN)
unnamed: D509.1 (DOUT), D510.3 (DIN)
unnamed: D510.1 (DOUT), D511.3 (DIN)
unnamed: D511.1 (DOUT), D512.3 (DIN)
unnamed: D512.1 (DOUT), D513.3 (DIN)
unnamed: D513.1 (DOUT), D514.3 (DIN)
unnamed: D514.1 (DOUT), D515.3 (DIN)
unnamed: D515.1 (DOUT), D516.3 (DIN)
unnamed: D516.1 (DOUT), D517.3 (DIN)
unnamed: D517.1 (DOUT), D518.3 (DIN)
unnamed: D518.1 (DOUT), D519.3 (DIN)
unnamed: D519.1 (DOUT), D520.3 (DIN)
unnamed: D520.1 (DOUT), D521.3 (DIN)
unnamed: D521.1 (DOUT), D522.3 (DIN)
unnamed: D522.1 (DOUT), D523.3 (DIN)
unnamed: D523.1 (DOUT), D524.3 (DIN)
unnamed: D524.1 (DOUT), D525.3 (DIN)
unnamed: D525.1 (DOUT), D526.3 (DIN)
unnamed: D526.1 (DOUT), D527.3 (DIN)
unnamed: D527.1 (DOUT), D528.3 (DIN)
unnamed: D528.1 (DOUT), D529.3 (DIN)
unnamed: D529.1 (DOUT), D530.3 (DIN)
unnamed: D530.1 (DOUT), D531.3 (DIN)
unnamed: D531.1 (DOUT), D532.3 (DIN)
unnamed: D532.1 (DOUT), D533.3 (DIN)
unnamed: D533.1 (DOUT), D534.3 (DIN)
unnamed: D534.1 (DOUT), D535.3 (DIN)
unnamed: D535.1 (DOUT), D536.3 (DIN)
unnamed: D536.1 (DOUT), D537.3 (DIN)
unnamed: D537.1 (DOUT), D538.3 (DIN)
unnamed: D538.1 (DOUT), D539.3 (DIN)
unnamed: D539.1 (DOUT), D540.3 (DIN)
unnamed: D540.1 (DOUT), D541.3 (DIN)
unnamed: D541.1 (DOUT), D542.3 (DIN)
unnamed: D542.1 (DOUT), D543.3 (DIN)
unnamed: D543.1 (DOUT), D544.3 (DIN)
unnamed: D544.1 (DOUT), D545.3 (DIN)

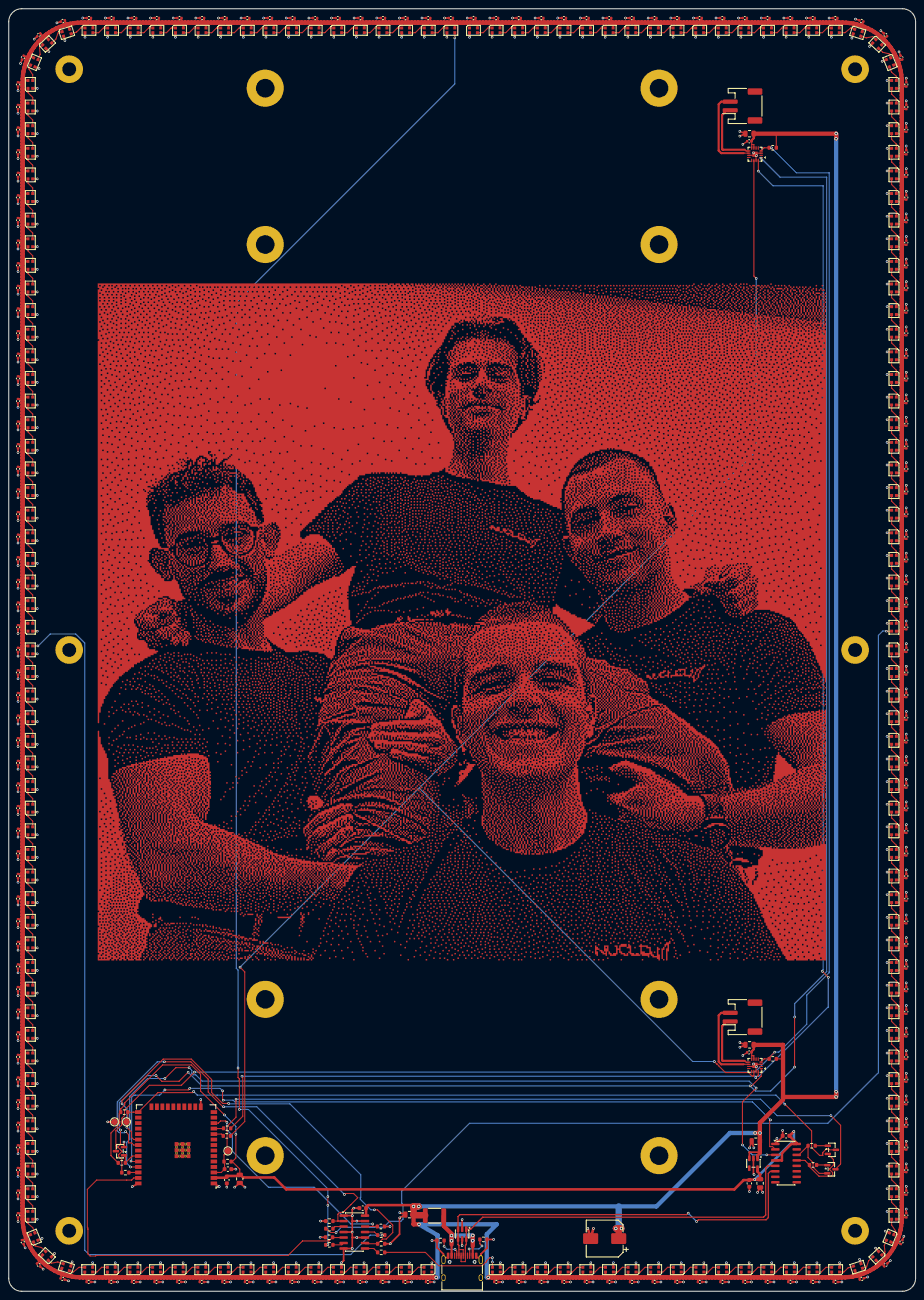
[picture p11: board fra_clock.kicad_pcb from above]

Board: 2 copper layers, 210.0 x 297.0 mm, 428 parts (0 on the bottom side), 216 nets.

Other parts of the board:
ART1: ART_FOTO
H1, H2, H7, H8, H13, H14: MountingHole_3.2mm_M3_Pad
H3, H4, H5, H6, H9, H10, H11, H12: MountingHole_4.3mm_M4_Pad
LS1, LS2: CE08483; Speaker_Makerverse_CE08483_100x45
