albertoboffi-PERSONAL/fra-clock/(commit log)

2026-10-11 pre-routing
    Claude-Session: https://claude.ai/code/session_01UYk7fLNsQphaXPRGVQJ5XY
    [fra_clock.dsn, fra_clock.kicad_pcb, fra_clock.kicad_sch, led_ring.kicad_sch]
2026-10-11 Phase A: critical routing (CRITICAL_AUTO) - power, USB, audio outputs, GND vias
    DRC A: 0 errors besides unconnected Phase-B nets; warnings: 14 pre-existing lib_footprint_mismatch, 4 dangling LED_x_DIN vias (Phase B).
    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
    [fra_clock.kicad_pcb]
2026-10-11 Phase B: Freerouting 2.5.0 + scripted fixes (FREEROUTE_AUTO), GND plane continuity
    DRC B: 0 errors, 0 unconnected, 0 schematic parity issues; only 14 pre-existing lib_footprint_mismatch warnings.
    Phase A updated: J1 GND ties, U6 GND spine, C69.2 tie.
    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
    [fra_clock.kicad_pcb]
2026-10-11 Art + 3D: photo footprint (F.Cu/F.Mask), Makerverse speakers on front, C69 to front east of J1, CRITICAL_AUTO regenerated
    [fra_clock.kicad_pcb]
2026-10-12 3D: LCSC/EasyEDA models for USB-C, JST PH, WS2812B-2020, MAX98357A TQFN; generic 1812 for F1
    [fra_clock.kicad_pcb]
2026-10-12 Production: Gerber, drill, JLCPCB BOM/CPL
    [fra_clock-B_Cu.gbl, fra_clock-B_Mask.gbs, fra_clock-B_Paste.gbp, fra_clock-B_Silkscreen.gbo, fra_clock-Edge_Cuts.gm1, fra_clock-F_Cu.gtl, fra_clock-F_Mask.gts, fra_clock-F_Paste.gtp]
2026-10-12 Restructure repository for GitHub
    - KiCad project moved to hardware/ (project-relative library and 3D paths unchanged)
    - production/: gerber/, assembly/ (BOM, CPL), preview/; removed duplicate gerber.zip (Finder archive with __MACOSX entries)
    - docs/: routing-report.md (paths and commit hashes updated), checks/ (DRC and verification outputs), images/ (3D renders)
    - art/: source/ and generated/
    - scripts/: kicad/, routing/{phase_a,phase_b,data}/, art/, production/; shell scripts updated to the new paths
    - removed stale pre-routing Specctra export fra_clock.dsn
    - README.md and scripts/README.md
    Claude-Session: https://claude.ai/code/sess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
    [fra_clock.dsn, fra_clock.kicad_pcb, fra_clock.kicad_sch, fra_clock_BOM_JLCPCB.csv, led_ring.kicad_sch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]
